mkind06/sensor_fugas_TEI201-/diseno_3d/fusion360/README.md

# Archivos Fusion 360

> **Plantilla para una etapa posterior: no corresponde rellenarla en Avance 2.** Archivo nativo v3 e historial. El contenido siguiente se conserva como referencia; sus cifras, componentes de ejemplo, marcas de verificación y frases de logro no son resultados del Alpha ni requisitos adicionales de la guía actual. Ver la [documentación de esta entrega](../README.md).

## Archivos Requeridos

### `modelo_completo_v3.f3d`
Archivo principal con **historial de cambios completo**

**DEBE INCLUIR:**
-  Todos los componentes modelados
-  Ensamble completo funcional
-  Historial de diseño (timeline)
-  Materiales asignados
-  Constraints y relaciones

---

## Estructura del Modelo

### Componentes (Components)
```
Ensamble_Principal
├── Encapsulado_Inferior
├── Encapsulado_Superior
├── ESP32_DevKit
├── Sensor_DHT22
├── LED_Indicador
├── Soporte_Bateria
├── Bracket_Montaje
└── Tornilleria
```

### Uniones (Joints)
Documentar las juntas principales y sus restricciones

### Parámetros
Listar parámetros principales utilizados:
- `ancho_total = 120mm`
- `alto_total = 80mm`
- `grosor_pared = 2mm`

---

## Instrucciones de Apertura

1. Abrir Fusion 360
2. File > Open > Seleccionar archivo `.f3d`
3. Verificar que todas las referencias están cargadas
4. Revisar timeline para ver historial

---

## Versiones

| Versión | Fecha | Cambios Principales |
|---|---|---|
| v3.0 | [Fecha] | Versión final para Avance #3 |
| v2.1 | [Fecha] | Ajustes post Avance #2 |
| v1.0 | [Fecha] | Primera versión funcional |

---
