mkind06/sensor_fugas_TEI201-/diseno_3d/planos/README.md

# Planos Técnicos

> **Plantilla para una etapa posterior: no corresponde rellenarla en Avance 2.** Planos de fabricación v3. El contenido siguiente se conserva como referencia; sus cifras, componentes de ejemplo, marcas de verificación y frases de logro no son resultados del Alpha ni requisitos adicionales de la guía actual. Ver la [documentación de esta entrega](../README.md).

## Planos Requeridos

### 1. Plano de Conjunto
`plano_conjunto_v3.pdf`

Incluir:
- Vistas principales (frontal, lateral, superior)
- Escala apropiada
- Cotas principales externas
- Tabla de piezas

### 2. Planos de Detalle
Para cada componente crítico del encapsulado:
- Cotas completas
- Tolerancias importantes
- Notas de fabricación

---

## Estándares de Planos

### Vistas Ortogonales Requeridas
- Vista Frontal
- Vista Superior
- Vista Lateral Derecha
- Vista Isométrica (referencia)

### Cortes
- Corte A-A: Sección transversal mostrando interior
- Corte B-B: (si es necesario para claridad)

---

## Formato de Planos

**Tamaño de hoja:** A4 o A3  
**Orientación:** Según convenga  
**Escala:** 1:1, 1:2, o según sea necesario  
**Unidades:** Milímetros (mm)

### Información en Cajetín
- Título del proyecto
- Nombre de la pieza/ensamble
- Escala
- Material
- Fecha
- Versión
- Integrantes del equipo

---

## Acotación

### Reglas Generales
- Cotas en milímetros sin unidad
- Líneas de cota finas
- Texto legible (mín. 2.5mm de altura)
- Cotas críticas resaltadas

### Tolerancias
Indicar tolerancias para:
- Orificios de tornillos: ±0.1mm
- Encajes: +0.2mm / +0.0mm
- Dimensiones generales: ±0.5mm

---

## Exportación desde Fusion 360

```
Opción 1: Drawing (Plano tradicional)
1. Create Drawing
2. Configurar vistas y cotas
3. Export como PDF

Opción 2: Export directo
File > Export > Formato PDF/DWG
```

---

## Archivos a Entregar

- `plano_conjunto_v3.pdf` - Plano principal
