mkind06/sensor_fugas_TEI201-/iteraciones/iteracion_1/README.md

# Iteración 1 - Concepto Inicial

> **Antecedente histórico conservado.** Este documento precede a la revisión del Avance 2 y no acredita por sí solo la entrega oficial de Avance 1. Su fecha, referencias a v1 y diagnósticos causales no fueron corroborados con registros completos. Para la evolución sustentada del Alpha, consultar el [historial actualizado](../README.md) y los [registros disponibles](../../testing/datos/diagnostico.md). K2=275 y la ventana de 3 s son antecedentes; la configuración actual es K2=229 y 10 s.

## Información General
**Fecha:** 19/10/2026
**Versión:** v1.0
**Estado:** Prueba de concepto en protoboard
**Avance asociado:** Avance #1 / inicio del Avance #2

---

## Descripción
Primer montaje del detector: dos sensores de flujo en serie con una llave de paso entre ellos, para comprobar que comparar caudal de entrada y salida permite detectar una fuga.

**Objetivo de esta iteración:**
- Leer los pulsos de dos FS400A con la ESP32-S3.
- Convertir pulsos a caudal.
- Encender LED según la diferencia entre sensores.
- Armar el circuito hidráulico: bomba → sensor 1 → llave → sensor 2 → recipiente.

---

## Componentes Utilizados

### Hardware
- Microcontrolador: ESP32-S3 Super Mini
- Sensores: 2 × FS400A (1″, 1–60 L/min)
- Actuadores: 3 LED (verde, amarillo, rojo) con 330 Ω
- Otros: divisores 10k/20k, bomba sumergible USB, llave de paso, mangueras, 2 mini protoboards

### Software
- IDE: Arduino IDE 1.8.19
- Librerías: ninguna externa
- Versión código: v1.0 (conteo de pulsos sin filtro, ventana de 3 s)

---

## Fotos del Prototipo
- `v1_circuito_protoboard.jpg` – pendiente
- `v1_vista_general.jpg` – pendiente

---

## Resultados de Testing Inicial

### Funcionalidad Lograda
✅ Lectura de pulsos de ambos sensores
✅ Circuito hidráulico armado
❌ LED: el rojo encendía con la salida apagada
❌ Lecturas confiables: pulsos falsos y caudales irreales

### Problemas Identificados

1. **LED rojo encendido con la salida apagada**
   - Causa: cable de GND conectado a 3V3 y LED invertido.
   - Solución: cable al pin GND y LED girado.

2. **Error al compilar (`setup()` redefinido)**
   - Causa: dos programas en pestañas del mismo proyecto.
   - Solución: proyecto separado con una sola pestaña.

3. **~1300 pulsos/s sin agua circulando**
   - Causa: ruido del motor de la bomba por la tierra USB compartida con el PC.
   - Solución: bomba con cargador propio + filtro por software.

4. **Caudales irreales (hasta 49 L/min)**
   - Causa: ruido + flujo irregular.
   - Solución: las mismas del punto 3.

5. **Turbinas detenidas**
   - Causa: la bomba se sostenía con la mano y el agua escapaba.
   - Solución: boquilla sellada dentro de la manguera con cinta.

---

## Aprendizajes

### Técnicos
- Un motor comparte ruido por la tierra USB: hay que separar su alimentación.
- Un número "posible" en pantalla no es necesariamente real: 49 L/min con una bomba pequeña indicaba ruido.

### De Diseño
- El circuito hidráulico necesita uniones selladas para que el caudal supere el mínimo del sensor.

---

## Plan para Iteración 2

**Hardware:**
- [x] Alimentar la bomba por separado
- [x] Corregir cableado de LED
- [x] Sellar la boquilla de la bomba

**Software:**
- [x] Filtro anti-ruido por software
- [x] Calibrar los sensores entre sí
- [x] Ajustar la ventana de medición

**Diseño:**
- [x] Iniciar diseño de encapsulado

---

## Archivos en esta Carpeta
- `v1_codigo.ino` – pendiente (si se conserva la versión sin filtro)
- `v1_fotos/` – pendiente
