mkind06/sensor_fugas_TEI201-/documentacion/reporte_final/README.md

# Reporte Final del Proyecto

> **Plantilla para una etapa posterior: no corresponde rellenarla en Avance 2.** Reporte final de Avance 3. El contenido siguiente se conserva como referencia; sus cifras, componentes de ejemplo, marcas de verificación y frases de logro no son resultados del Alpha ni requisitos adicionales de la guía actual. Ver la [documentación de esta entrega](../README.md).

## Formato del Documento

**Archivo:** `reporte_final_v3.pdf`

**Especificaciones:**
- Formato: PDF
- Páginas: Máximo 15 páginas
- Tamaño: A4
- Márgenes: 2.5 cm todos los lados
- Fuente: Arial o Times New Roman, 11-12 pt
- Interlineado: 1.5
- Incluir numeración de páginas
- Incluir encabezado con nombre del proyecto

---

## Estructura Sugerida

### Portada (1 página)
- Título del proyecto
- Logo Universidad/Curso
- Integrantes del equipo
- Profesor
- Fecha
- ODS Seleccionado

### Resumen Ejecutivo (0.5 páginas)
- Problema abordado
- Solución desarrollada
- Resultados principales
- Conclusión clave

### 1. Introducción (1 página)
- Contexto general
- Problemática ODS específica
- Objetivos del proyecto
- Alcance

### 2. Marco Teórico/Estado del Arte (1-1.5 páginas)
- ODS seleccionado - descripción
- Problemática local/nacional
- Soluciones existentes (breve revisión)
- Justificación de la propuesta

### 3. Metodología (1 página)
- Proceso de diseño seguido
- Herramientas utilizadas
- Enfoque de desarrollo

### 4. Diseño y Desarrollo (3-4 páginas)

#### 4.1 Arquitectura del Sistema
- Diagrama de bloques general
- Componentes principales

#### 4.2 Hardware
- Esquema del circuito (imagen)
- Componentes seleccionados y justificación
- BOM (tabla resumida)

#### 4.3 Software
- Arquitectura del software
- Diagrama de flujo principal
- Librerías utilizadas

#### 4.4 Diseño Mecánico/3D
- Renders del modelo (2-3 imágenes)
- Consideraciones de diseño
- Especificaciones

### 5. Proceso de Iteraciones (2 páginas)
- Versión 1: Concepto inicial
- Versión 2: Primera iteración (Avance #2)
- Versión 3: Versión final (Avance #3)
- Tabla comparativa de mejoras
- Justificación de cambios

### 6. Testing y Validación (2-3 páginas)

#### 6.1 Metodología de Testing
- Protocolo aplicado
- Perfil de usuarios

#### 6.2 Resultados Cuantitativos
- Tablas y gráficos
- Análisis estadístico

#### 6.3 Resultados Cualitativos
- Feedback de usuarios
- Observaciones

#### 6.4 Validación de Impacto ODS
- Métricas de impacto
- Comparación baseline vs. resultado
- Proyección de escalabilidad

### 7. Conclusiones (1 página)
- Logros alcanzados
- Limitaciones identificadas
- Aprendizajes del equipo
- Trabajo futuro y mejoras potenciales

### 8. Referencias (0.5 páginas)
- Bibliografía
- Datasheets consultados
- Recursos web

### Anexos (opcional, no cuenta para 15 páginas)
- Código completo
- Datos raw de testing
- Documentación extendida

---

## Calidad del Contenido

### Texto
- Redacción clara y profesional
- Sin errores ortográficos ni gramaticales
- Evitar lenguaje coloquial
- Uso correcto de terminología técnica

### Figuras y Tablas
- Todas las figuras numeradas: "Figura 1: ..."
- Todas las tablas numeradas: "Tabla 1: ..."
- Alta resolución y legibles
- Referencias en el texto: "como se muestra en la Figura 3..."

### Referencias
Formato APA o IEEE consistente:
```
[1] Apellido, N. (Año). Título. Editorial.
[2] Autor. "Título del artículo". Revista, vol. X, pp. XX-XX, Año.
```

---

## Checklist de Calidad

Antes de entregar, verificar:

**Contenido:**
- [ ] Todas las secciones completas
- [ ] Figuras de alta calidad
- [ ] Tablas con datos reales
- [ ] Referencias correctamente citadas
- [ ] Máximo 15 páginas (sin contar anexos)

**Formato:**
- [ ] PDF exportado correctamente
- [ ] Numeración de páginas
- [ ] Encabezados consistentes
- [ ] Márgenes correctos
- [ ] Sin imágenes pixeladas

**Revisión:**
- [ ] Sin errores ortográficos
- [ ] Redacción clara y coherente
- [ ] Todos los integrantes revisaron
- [ ] Cumple con rúbrica de evaluación
