mkind06/sensor_fugas_TEI201-/testing/reportes/README.md

# Reportes de Testing

> **Plantilla para una etapa posterior: no corresponde rellenarla en Avance 2.** Reportes de usuarios e impacto de etapas posteriores. El contenido siguiente se conserva como referencia; sus cifras, componentes de ejemplo, marcas de verificación y frases de logro no son resultados del Alpha ni requisitos adicionales de la guía actual. Ver la [documentación de esta entrega](../README.md).

## Formato del Reporte Principal

### `reporte_testing_usuarios_v3.pdf`

**Estructura sugerida:**

1. **Introducción**
   - Objetivo del testing
   - Metodología utilizada

2. **Descripción de Participantes**
   - Perfil de usuarios
   - Cantidad y demografía

3. **Protocolo Aplicado**
   - Pasos del testing
   - Preguntas realizadas
   - Métricas evaluadas

4. **Resultados Cuantitativos**
   - Tablas de datos
   - Gráficos de resultados
   - Análisis estadístico básico

5. **Resultados Cualitativos**
   - Feedback de usuarios
   - Observaciones del equipo
   - Problemas identificados

6. **Validación de Impacto ODS**
   - Métricas de impacto medidas
   - Comparación con situación inicial
   - Proyección de escalabilidad

7. **Conclusiones**
   - Fortalezas del prototipo
   - Limitaciones identificadas
   - Recomendaciones para mejoras futuras

8. **Anexos**
   - Formularios utilizados
   - Consentimientos informados
   - Datos raw

---

## Reportes Complementarios

### `analisis_metricas_ods.pdf`
Enfoque específico en validación de impacto ODS

### `feedback_usuarios.pdf`
Compilación de comentarios y sugerencias

### `comparativa_iteraciones.pdf`
Evolución del desempeño entre versiones v1, v2, v3

---

## Datos a Incluir

### Tablas de Resultados
Ejemplo de formato:

| Usuario | Edad | Facilidad de Uso (1-5) | Satisfacción (1-5) | Comentarios |
|---|---|---|---|---|
| U1 | [edad] | 4 | 5 | "Muy intuitivo" |
| U2 | [edad] | 5 | 4 | "Funciona bien" |

### Gráficos Recomendados
- Gráfico de barras: Promedios por métrica
- Gráfico de dispersión: Correlaciones
- Gráfico de líneas: Evolución entre iteraciones
