mkind06/sensor_fugas_TEI201-/documentacion/presentacion/README.md

# Presentación Final

> **Plantilla para una etapa posterior: no corresponde rellenarla en Avance 2.** Presentación final de Avance 3. El contenido siguiente se conserva como referencia; sus cifras, componentes de ejemplo, marcas de verificación y frases de logro no son resultados del Alpha ni requisitos adicionales de la guía actual. Ver la [documentación de esta entrega](../README.md).

## Formato de la Presentación

**Archivo:** `presentacion_avance3.pdf` o `.pptx`

**Especificaciones:**
- Duración: 10 minutos
- Slides: 10-15 slides recomendado
- Formato: 16:9 (widescreen)
- Fuente mínima: 24pt para texto, 32pt para títulos

---

## Estructura de la Presentación (10 min total)

### Slide 1: Portada (30 seg)
- Título del proyecto
- Integrantes
- ODS Seleccionado
- Logo Universidad/Curso

### Slides 2-3: Contexto y Problema
**Slide 2: Problemática ODS**
- Descripción del ODS seleccionado
- Datos de contexto (estadísticas, impacto)
- Foto/imagen representativa

**Slide 3: Problema Específico**
- Problema local identificado
- ¿Por qué es importante?
- ¿A quiénes afecta?

### Slides 4-6: Solución Técnica
**Slide 4: Visión General**
- ¿Qué hace el sistema?
- Diagrama de bloques simple
- Foto del prototipo

**Slide 5: Hardware**
- Componentes principales
- Esquema del circuito (simplificado)
- Sensores y actuadores

**Slide 6: Software y Diseño 3D**
- Arquitectura del software
- Render del modelo 3D
- Características clave

### Slides 7-8: Iteraciones y Refinamiento
**Slide 7: Evolución del Diseño**
- Imágenes de v1, v2, v3 lado a lado
- Cambios principales entre versiones

**Slide 8: Mejoras Cuantitativas**
- Tabla/gráfico comparativo
- Métricas de mejora
- Feedback incorporado

### Slides 9-10: Validación y Resultados
**Slide 9: Testing con Usuarios**
- Fotos de sesiones
- Cantidad de usuarios testeados
- Metodología aplicada

**Slide 10: Resultados e Impacto ODS**
- Gráficos de resultados cuantitativos
- Métricas de impacto ODS
- Feedback cualitativo destacado

### Slide 11: Demostración en Vivo
**Slide de transición:**
- "Demo en vivo"
- [Realizar demostración del prototipo funcionando]
- Mostrar casos de uso principales

### Slide 12: Conclusiones
- Logros alcanzados
- Limitaciones identificadas
- Aprendizajes del equipo

### Slide 13: Trabajo Futuro
- Mejoras potenciales
- Escalabilidad
- Próximos pasos

### Slide 14: Preguntas
- "¿Preguntas?"
- Información de contacto (opcional)

---

## Diseño Visual

### Principios de Diseño
- **Minimalismo:** Poco texto, más imágenes
- **Regla 6×6:** Máximo 6 bullets × 6 palabras
- **Una idea por slide:** No sobrecargar
- **Alto contraste:** Texto legible desde lejos

### Elementos Visuales
- Fotos de alta calidad (>1920×1080)
- Iconos y gráficos profesionales
- Gráficos de datos claros y grandes
- Colores consistentes con identidad del proyecto

### Tipografía
- Títulos: 32-44 pt, negrita
- Texto: 24-28 pt
- Fuentes sans-serif (Arial, Calibri, Helvetica)

---

## Recomendaciones de Presentación

### Preparación
- **Ensayar múltiples veces:** Medir tiempos
- **Repartir roles:** Cada integrante presenta secciones
- **Preparar demo:** Tener backup por si falla
- **Anticipar preguntas:** Preparar respuestas

### Durante la Presentación
- **Volumen y claridad:** Hablar alto y claro
- **Contacto visual:** Mirar a la audiencia, no leer slides
- **Fluidez:** Transiciones naturales entre speakers
- **Manejo de tiempo:** Respetar 10 minutos
- **Confianza:** Mostrar dominio del tema

### Demo en Vivo
- Tener prototipo listo y funcionando ANTES
- Explicar QUÉ se está mostrando
- Mostrar sensores capturando datos
- Mostrar actuadores respondiendo
- Tener plan B si falla (video de respaldo)

---

## Checklist Pre-Presentación

### 1 día antes:
- [ ] Presentación finalizada y revisada
- [ ] Ensayo completo del equipo
- [ ] Prototipo funcionando perfectamente
- [ ] Baterías cargadas / fuentes listas
- [ ] Video de backup de la demo grabado

### Día de presentación:
- [ ] Llegar 15 min antes
- [ ] Probar prototipo en el lugar
- [ ] Probar conexión de laptop a proyector
- [ ] Tener presentación en USB de respaldo
- [ ] Todos los integrantes presentes y preparados

---
