mkind06/sensor_fugas_TEI201-/iteraciones/iteracion_3/README.md

# Iteración 3 - Versión Final

> **Plantilla para una etapa posterior: no corresponde rellenarla en Avance 2.** Iteración final v3. El contenido siguiente se conserva como referencia; sus cifras, componentes de ejemplo, marcas de verificación y frases de logro no son resultados del Alpha ni requisitos adicionales de la guía actual. Ver la [documentación de esta entrega](../iteracion_2/README.md).

## Información General

**Fecha:** [XX/XX/2025]  
**Versión:** v3.0  
**Estado:** Prototipo de alta resolución - Versión final  
**Avance asociado:** Avance #3

---

## Descripción

Versión final del prototipo, incorporando todas las mejoras y refinamientos basados en feedback de v2 y testing extensivo con usuarios. Sistema robusto, probado y listo para piloto en contexto real.

**Objetivos alcanzados:**
- Prototipo completamente funcional y robusto
- Encapsulado finalizado con todos los componentes
- Validación con 5+ usuarios del grupo objetivo
- Métricas de impacto ODS cuantificadas
- Sistema instalable en contexto de riego agrícola real (objetivo pendiente de esta plantilla)

---

## Cambios Respecto a v2

### Hardware
**Mejoras implementadas:**
1. [Mejora 1]
   - Razón: [Feedback de v2 / necesidad identificada]
   - Impacto: [Mejora cuantitativa]

2. [Mejora 2]
   - Razón: [Feedback de v2 / necesidad identificada]
   - Impacto: [Mejora cuantitativa]

**Cambios finales:**
- [Cambio técnico específico]
- [Optimización final]

### Software
**Nuevas funcionalidades:**
- [Feature final 1]
- [Feature final 2]

**Optimizaciones finales:**
- [Optimización de código]
- [Mejora de eficiencia]

**Manejo de errores:**
- Implementado manejo robusto de casos extremos
- Mensajes de error informativos
- Recuperación automática ante fallas menores

### Diseño Mecánico
**Encapsulado finalizado:**
- Diseño optimizado para impresión 3D
- Todos los componentes integrados
- Sistema de montaje robusto
- Accesibilidad para mantenimiento
- Resistencia a condiciones ambientales

---

## Fotos del Prototipo Final

Incluir en esta carpeta:
- `v3_prototipo_final_frontal.jpg`
- `v3_prototipo_final_posterior.jpg`
- `v3_interior_componentes.jpg`
- `v3_instalado_contexto.jpg`
- `v3_detalle_sensores.jpg`
- `v3_testing_usuarios.jpg` (múltiples)

---

## Resultados Finales

### Funcionalidad Completa
✅ [Todas las funciones planificadas]  
✅ Sistema opera sin intervención manual  
✅ Conectividad estable  
✅ Interfaz de usuario funcional  
✅ Manejo robusto de errores  

### Testing con 5+ Usuarios

**Participantes:**
- N = [número] usuarios
- Perfil: [Descripción del grupo objetivo]

**Resultados cuantitativos:**
| Métrica | Promedio | Desv. Std. |
|---|---|---|
| Facilidad de uso (1-5) | [X.X] | [X.X] |
| Satisfacción (1-5) | [X.X] | [X.X] |
| Tiempo completar tarea (seg) | [XX] | [XX] |
| Errores cometidos | [X.X] | [X.X] |

**Feedback cualitativo más relevante:**
- Positivo: "[Cita de usuario]"
- Positivo: "[Cita de usuario]"
- A mejorar: "[Cita de usuario]"

### Validación de Impacto ODS

**ODS Seleccionado:** [Número y nombre]

**Métricas de impacto:**

1. **[Métrica 1]**
   - Baseline (sin prototipo): [Valor]
   - Con prototipo: [Valor medido]
   - Mejora: [% o valor absoluto]

2. **[Métrica 2]**
   - Baseline: [Valor]
   - Con prototipo: [Valor medido]
   - Mejora: [% o valor absoluto]

**Proyección de impacto:**
Si se despliega a escala [barrio/ciudad/región]:
- [Impacto estimado cuantitativo]
- [Beneficiarios potenciales]

---

## Comparación de las 3 Iteraciones

| Aspecto | v1 | v2 | v3 | Mejora Total |
|---|----|----|----| ---|
| **Sensores** | 2/3 | 3/3 | 3/3 | ✅ 100% |
| **Actuadores** | 1/2 | 2/2 | 2/2 | ✅ 100% |
| **Tiempo respuesta (ms)** | 500 | 200 | 100 | ↓ 80% |
| **Consumo (mA)** | 250 | 180 | 120 | ↓ 52% |
| **Tasa errores (%)** | 15 | 5 | 1 | ↓ 93% |
| **Encapsulado** | ❌ | Prototipo | Finalizado | ✅ |
| **Usuarios testeados** | 0 | 2 | 5+ | ✅ |
| **Satisfacción (1-5)** | - | 3.8 | 4.5 | ↑ 18% |
| **Impacto ODS validado** | ❌ | Parcial | ✅ Completo | ✅ |

---

## Fortalezas del Prototipo Final

1. **[Fortaleza 1]**
   - Evidencia: [Datos de testing]

2. **[Fortaleza 2]**
   - Evidencia: [Feedback de usuarios]

3. **[Fortaleza 3]**
   - Evidencia: [Métricas técnicas]

---

## Limitaciones Identificadas

1. **[Limitación 1]**
   - Descripción: [Detalles]
   - Impacto: [Evaluación]
   - Posible solución futura: [Ideas]

2. **[Limitación 2]**
   - Descripción: [Detalles]
   - Impacto: [Evaluación]
   - Posible solución futura: [Ideas]

---

## Aprendizajes del Proceso Completo

### Técnicos
1. [Aprendizaje técnico importante]
2. [Aprendizaje técnico importante]

### De Diseño
1. [Lección sobre proceso de diseño]
2. [Lección sobre proceso de diseño]

### De Trabajo en Equipo
1. [Lección sobre colaboración]
2. [Lección sobre colaboración]

### De Gestión de Proyecto
1. [Lección sobre planificación]
2. [Lección sobre gestión de tiempo]

---

## Trabajo Futuro Recomendado

### Mejoras a Corto Plazo
- [ ] [Mejora 1]
- [ ] [Mejora 2]

### Mejoras a Mediano Plazo
- [ ] [Feature adicional 1]
- [ ] [Optimización 1]

### Escalabilidad
- [ ] [Consideración para producción masiva]
- [ ] [Modelo de negocio / sustentabilidad]
- [ ] [Alianzas estratégicas potenciales]

---

## Archivos en esta Carpeta

- `v3_codigo_final.ino` - Código final documentado
- `v3_esquema_final.png` - Esquema definitivo del circuito
- `v3_modelo3d_final.f3d` - Diseño 3D completo en Fusion 360
- `v3_fotos/` - Fotografías del prototipo final
- `v3_testing_completo.pdf` - Reporte de testing con usuarios
- `v3_comparativa_versiones.xlsx` - Datos comparativos v1-v2-v3
