mkind06/sensor_fugas_TEI201-/diseno_3d/cad/caja_impresion_1.step

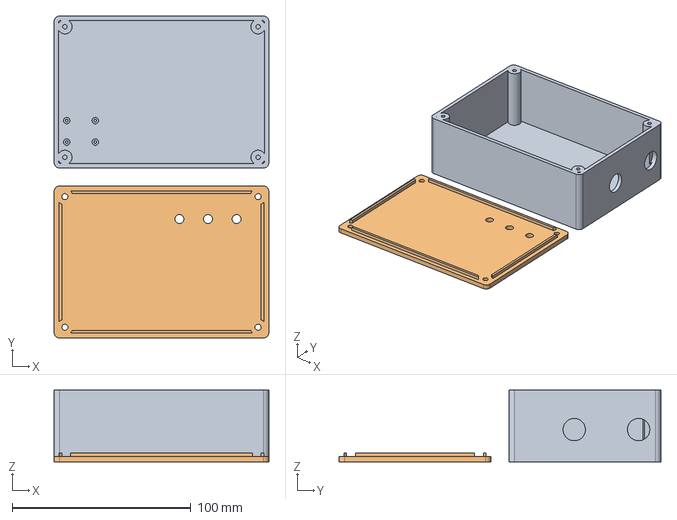
[picture p3: CAD file, 2026-10-21]
diseno_3d/cad/caja_impresion_1.step
120.0 x 180.0 x 40.0 mm
