mkind06/sensor_fugas_TEI201-/diseno_3d/cad/caja_planos.dxf

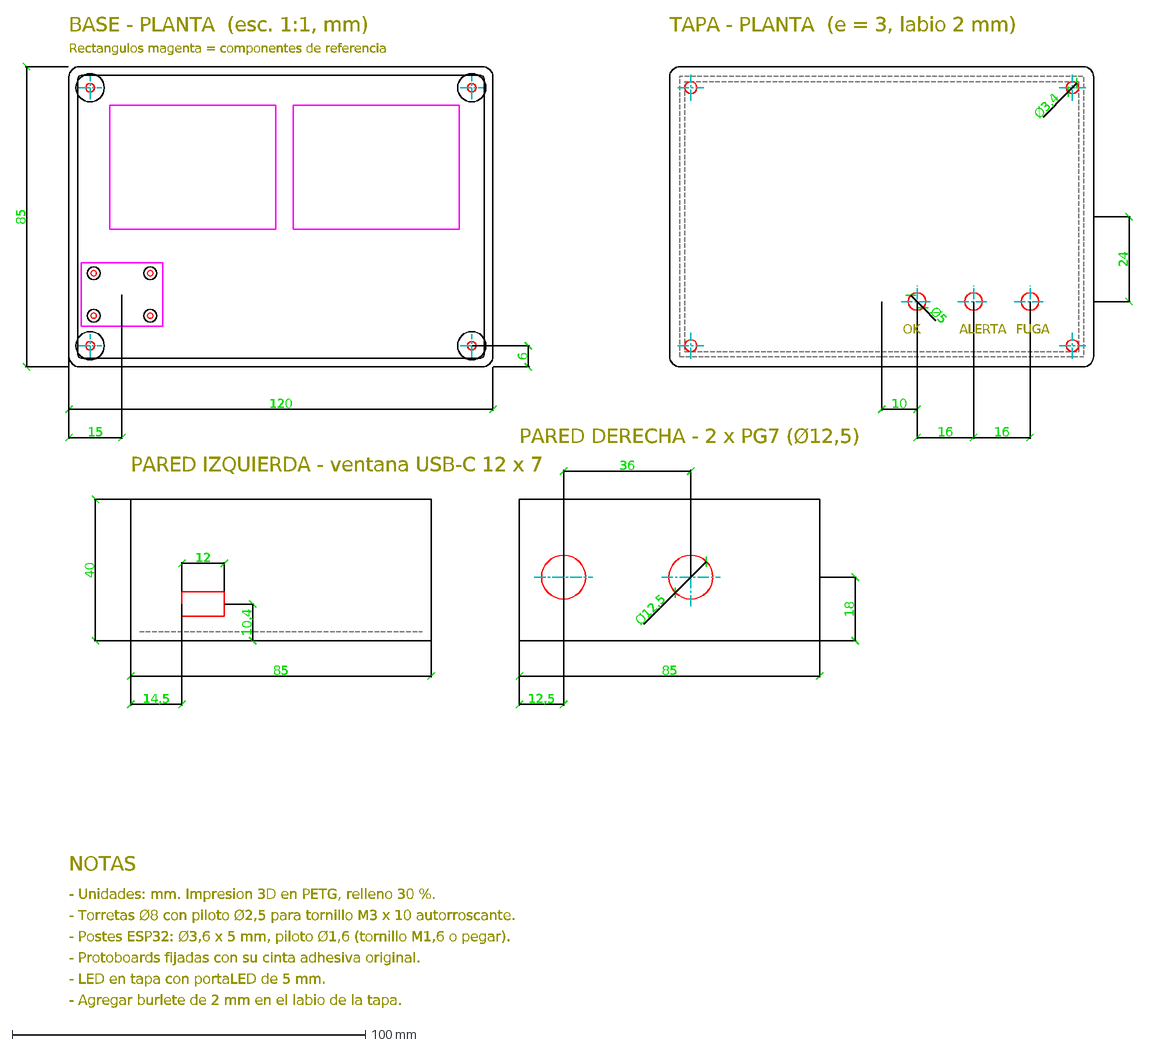
[picture p4: CAD file, 2026-10-21]
diseno_3d/cad/caja_planos.dxf
120
85
15
6
BASE - PLANTA (esc. 1:1, mm)
Rectangulos magenta = componentes de referencia
40
14,5
12
10,4
PARED IZQUIERDA - ventana USB-C 12 x 7
Ø12,5
36
12,5
18
PARED DERECHA - 2 x PG7 (Ø12,5)
Ø5
Ø3,4
10
16
24
OK
ALERTA
FUGA
TAPA - PLANTA (e = 3, labio 2 mm)
NOTAS
- Unidades: mm. Impresion 3D en PETG, relleno 30 %.
- Torretas Ø8 con piloto Ø2,5 para tornillo M3 x 10 autorroscante.
- Postes ESP32: Ø3,6 x 5 mm, piloto Ø1,6 (tornillo M1,6 o pegar).
- Protoboards fijadas con su cinta adhesiva original.
- LED en tapa con portaLED de 5 mm.
- Agregar burlete de 2 mm en el labio de la tapa.
