mkind06/sensor_fugas_TEI201-/testing/datos/lecturas_preajuste.csv

hora_monitor | q1_lmin | q2_lmin | dif_pct_transmitida | tot1_pulsos | tot2_pulsos | razon_acumulada | origen | condicion | k1 | k2 | estado_algoritmo | led
12:38:21.249 | 1.35 | 1.18 | 13.0 | 470 | 411 | 0.874 | MEDICION_REAL_TRANSCRITA | SIN_FUGA_INTENCIONAL_PREAJUSTE | 288 | 275 | POSIBLE FUGA | AMARILLO
12:38:31.283 | 1.37 | 1.16 | 15.9 | 536 | 464 | 0.866 | MEDICION_REAL_TRANSCRITA | SIN_FUGA_INTENCIONAL_PREAJUSTE | 288 | 275 | POSIBLE FUGA | AMARILLO
12:38:41.267 | 1.35 | 1.09 | 19.4 | 601 | 514 | 0.855 | MEDICION_REAL_TRANSCRITA | SIN_FUGA_INTENCIONAL_PREAJUSTE | 288 | 275 | POSIBLE FUGA | AMARILLO
12:38:51.247 | 1.29 | 1.05 | 18.9 | 663 | 562 | 0.848 | MEDICION_REAL_TRANSCRITA | SIN_FUGA_INTENCIONAL_PREAJUSTE | 288 | 275 | POSIBLE FUGA | AMARILLO
12:39:01.286 | 1.29 | 1.07 | 17.2 | 725 | 611 | 0.843 | MEDICION_REAL_TRANSCRITA | SIN_FUGA_INTENCIONAL_PREAJUSTE | 288 | 275 | POSIBLE FUGA | AMARILLO
12:39:11.254 | 1.33 | 1.11 | 16.5 | 789 | 662 | 0.839 | MEDICION_REAL_TRANSCRITA | SIN_FUGA_INTENCIONAL_PREAJUSTE | 288 | 275 | POSIBLE FUGA | AMARILLO
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
