mkind06/sensor_fugas_TEI201-/testing/datos/testeo_verde.csv

tiempo_virtual_s | q1_lmin | q2_lmin | dif_pct | origen | estado_esperado | led_esperado
10 | 1.30 | 1.339000 | -3.0 | DATOS_SINTETICOS | NORMAL | VERDE
20 | 1.33 | 1.369900 | -3.0 | DATOS_SINTETICOS | NORMAL | VERDE
30 | 1.32 | 1.280400 | 3.0 | DATOS_SINTETICOS | NORMAL | VERDE
40 | 1.37 | 1.359040 | 0.8 | DATOS_SINTETICOS | NORMAL | VERDE
50 | 1.37 | 1.361780 | 0.6 | DATOS_SINTETICOS | NORMAL | VERDE
60 | 1.39 | 1.363590 | 1.9 | DATOS_SINTETICOS | NORMAL | VERDE
70 | 1.31 | 1.290350 | 1.5 | DATOS_SINTETICOS | NORMAL | VERDE
80 | 1.34 | 1.322580 | 1.3 | DATOS_SINTETICOS | NORMAL | VERDE
90 | 1.31 | 1.275940 | 2.6 | DATOS_SINTETICOS | NORMAL | VERDE
100 | 1.31 | 1.317860 | -0.6 | DATOS_SINTETICOS | NORMAL | VERDE
110 | 1.32 | 1.331880 | -0.9 | DATOS_SINTETICOS | NORMAL | VERDE
120 | 1.31 | 1.270700 | 3.0 | DATOS_SINTETICOS | NORMAL | VERDE
130 | 1.36 | 1.398080 | -2.8 | DATOS_SINTETICOS | NORMAL | VERDE
140 | 1.35 | 1.382400 | -2.4 | DATOS_SINTETICOS | NORMAL | VERDE
150 | 1.36 | 1.355920 | 0.3 | DATOS_SINTETICOS | NORMAL | VERDE
160 | 1.35 | 1.308150 | 3.1 | DATOS_SINTETICOS | NORMAL | VERDE
170 | 1.38 | 1.345500 | 2.5 | DATOS_SINTETICOS | NORMAL | VERDE
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
