mkind06/sensor_fugas_TEI201-/(commit log)

2026-10-19 Update README for Renders de Alta Calidad
2026-10-19 Add Bill of Materials section to README
2026-10-19 Add Esquemas de Circuito section to README
2026-10-19 Add prototype photographs section to README
2026-10-19 Rename README (5).md to Datos de Testing
2026-10-20 Restaurar plantillas de Iteración 2 y Presentación Final
    Claude-Session: https://claude.ai/code/session_01UipyGDteNsNmfAP88nXXPw
2026-10-20 Restaurar plantilla de Reporte Final del Proyecto
    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
2026-10-20 Organizar archivos en carpetas
    Cada plantilla pasa a ser el README.md de su carpeta (hardware, software,
    diseno_3d, testing, iteraciones, documentacion) y se actualizan las rutas internas.
    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
2026-10-21 Completar BOM con componentes confirmados
2026-10-21 Documentar circuito y coordenadas del montaje
2026-10-21 Completar manual de instalación operación y diagnóstico
2026-10-21 Documentar procedencia de fuentes y reconstrucciones
2026-10-21 Añadir panel USB reconstruido con origen de datos explícito
2026-10-21 Documentar Testeo y límites de la evidencia Alpha
2026-10-21 Incorporar mediciones reales diagnóstico y Testeo sintético trazable
    [lecturas_preajuste.csv, testeo_verde.csv]
2026-10-21 Completar Iteración 2 exclusivamente para Avance 2
2026-10-21 Incorporar STEP DXF originales y revisión de CAD conceptual
    [caja_impresion_1.step, caja_planos.dxf]
2026-10-21 Identificar firmware aportado por el equipo sin cambios de lógica
2026-10-21 Registrar código proporcionado y aclarar ventana de 10 segundos
2026-10-21 Confirmar procedencia del sketch de riego agrícola
2026-10-21 Documentar decisión de enfocar el proyecto en riego agrícola
2026-10-21 Corregir solo referencia urbana de plantilla a contexto agrícola
2026-10-21 Enlazar evidencia del montaje final desde el índice
2026-10-21 Registrar fotografías recibidas como evidencia de banco Alpha
2026-10-21 Enlazar revisión completa y precisar alcance de plantillas
2026-10-21 Precisar evidencia disponible y protocolo propuesto de cinco minutos
2026-10-21 Distinguir requisitos de la guía de archivos de evidencia sugeridos
2026-10-21 Rotular requisitos de renders como plantilla de otra etapa
2026-10-21 Precisar carácter histórico de Iteración 1 sin reconstruir entrega anterior
2026-10-21 Separar ejemplos de versión final de resultados del Alpha
2026-10-21 Distinguir presentación final de la demo de Avance 2
2026-10-21 Identificar reporte final como plantilla fuera de Avance 2
2026-10-21 Identificar encuestas y métricas de usuarios como ejemplos futuros
